kaseat/HWDG/(list of files, drawings)

Other design files:
Hardware/MainBord.PcbDoc
Hardware/MainBord.SchDoc
Hardware/Watchdog.PrjPcb
